bigtreetech/Tango-3D-Printer-Motherboard/Motherboard Picture/Motherboard.jpg

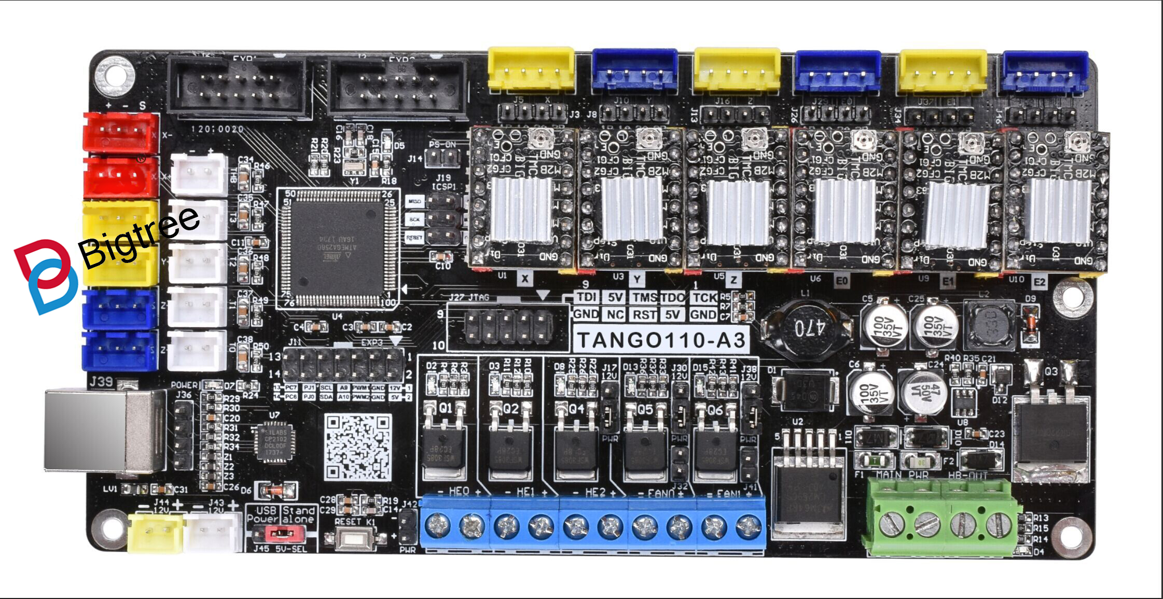
Motherboard Picture/Motherboard.jpg
