bigtreetech/Tango-3D-Printer-Motherboard/README.md

# Tango
An Open Source ATMEGA2560 based 3D printer controller board.
