bigtreetech/Tango-3D-Printer-Motherboard/PCB Diagram/Tango V1.0top.pdf

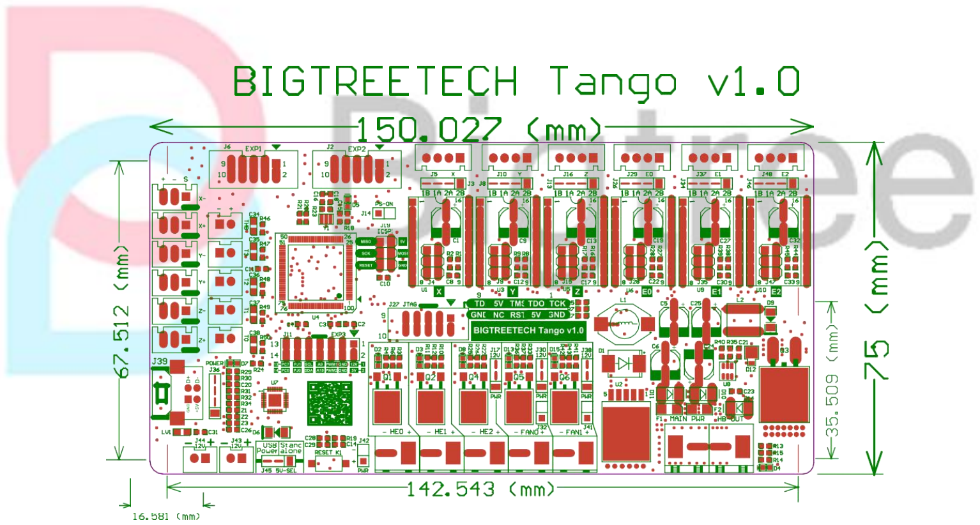
[picture p2: figure]
