bigtreetech/Tango-3D-Printer-Motherboard/Schematic/Tango V1.0.jpg

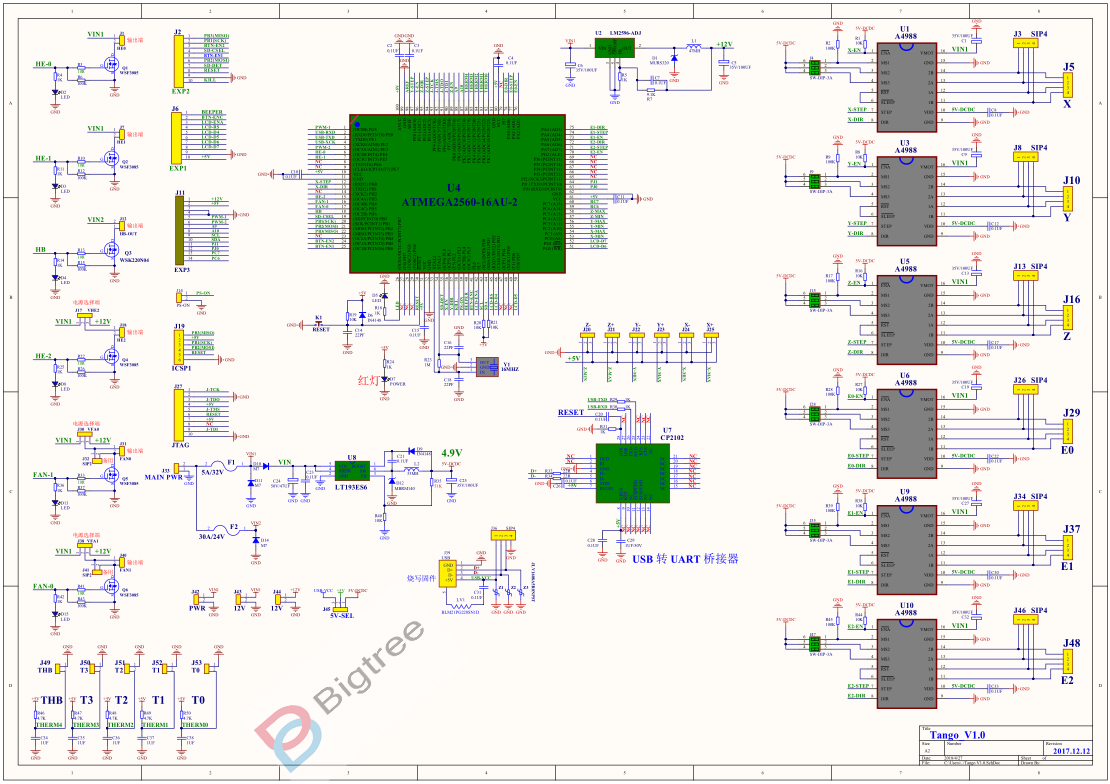
Schematic/Tango V1.0.jpg
