bigtreetech/Tango-3D-Printer-Motherboard/PCB Diagram/Tango V1bot.pdf

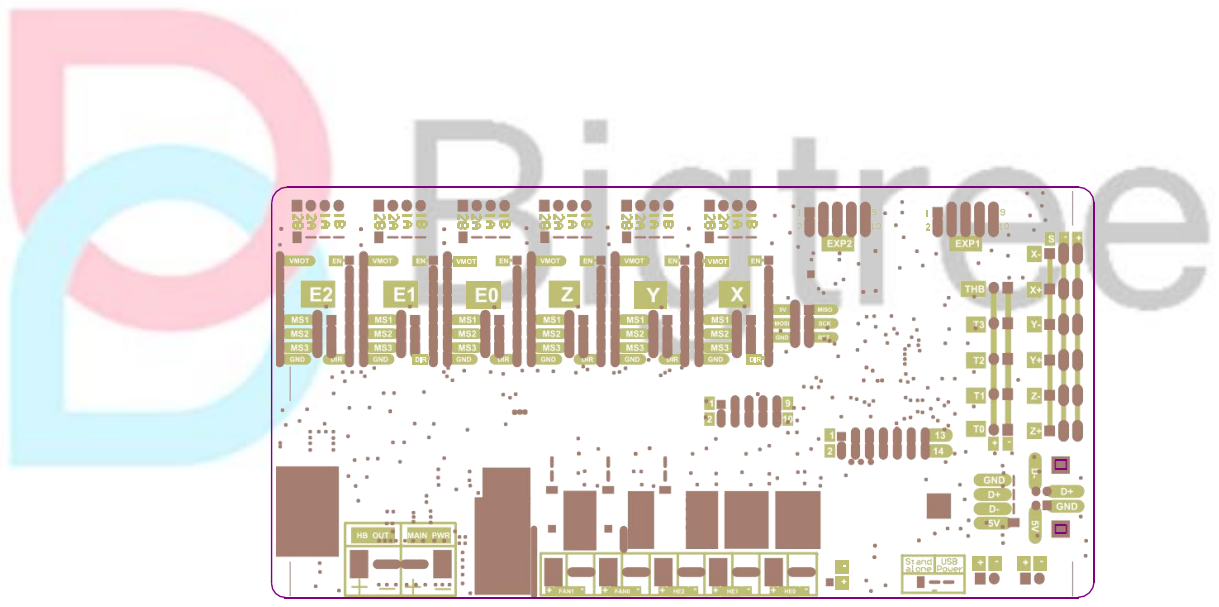
[picture p4: page 1]
