bigtreetech/Tango-3D-Printer-Motherboard/(list of files, drawings)

Other design files:
Schematic/Tango V1.0.SchDoc
