bigtreetech/Tango-3D-Printer-Motherboard/(threads)

Thread 3 (2019-02-09):

MARLIN ISSUES

ryanhmonument, 2019-02-09:
all three marlin tango revisions seem to be the same 1.1.8 and seem to be setup for a delta.. i'm fairly new to marlin, and i am trying to get my new board running on a cartesian, and currently i am getting an error as follows "homing_feedrate_xy was not declared in this scope" i have tried with my limited knowledge with no luck, if someone has the tango rumba up and running on a regular cartesian printer, i would love a copy and i cn just tweek my bed size, thermistors, probe, and leveling, lcd, and i should be able to upload and run, i have sucessfully got marlin uploaded to the board, however it's not a running setup, it says "printer killed, pleasse reset" after the marlin splash screen, i used my marlin setup that was running on my anet , nd just changed mother board to rumba. i am thankfull for any advice, or someone to share a running config..

jimhiggs, 2019-02-14:
I downloaded the stock Marlin 1.1.9 firmware and started from there. You are welcome to try my conf file.
Mine is a modified cubex wth E3d hotends, no hotbed  heater, raising bed Z azis and all endstops set for top, left, rear as 0,0,0 and I then use gcode to center 0,0,0  at center of bed.

/**
   Marlin 3D Printer Firmware
   Copyright (C) 2016 MarlinFirmware [https://github.com/MarlinFirmware/Marlin]

   Based on Sprinter and grbl.
   Copyright (C) 2011 Camiel Gubbels / Erik van der Zalm

   This program is free software: you can redistribute it and/or modify
   it under the terms of the GNU General Public License as published by
   the Free Software Foundation, either version 3 of the License, or
   (at your option) any later version.

   This program is distributed in the hope that it will be useful,
   but WITHOUT ANY WARRANTY; without even the implied warranty of
   MERCHANTABILITY or FITNESS FOR A PARTICULAR PURPOSE.  See the
   GNU General Public License for more details.

   You should have received a copy of the GNU General Public License
   along with this program.  If not, see <http://www.gnu.org/licenses/>.

*/

/**
   Configuration.h

   Basic settings such as:

   - Type of electronics
   - Type of temperature sensor
   - Printer geometry
   - Endstop configuration
   - LCD controller
   - Extra features

   Advanced settings can be found in Configuration_adv.h

*/
#ifndef CONFIGURATION_H
#define CONFIGURATION_H
#define CONFIGURATION_H_VERSION 010109

//===========================================================================
//============================= Getting Started =============================
//===========================================================================

/**
   Here are some standard links for getting your machine calibrated:

   http://reprap.org/wiki/Calibration
   http://youtu.be/wAL9d7FgInk
   http://calculator.josefprusa.cz
   http://reprap.org/wiki/Triffid_Hunter%27s_Calibration_Guide
   http://www.thingiverse.com/thing:5573
   https://sites.google.com/site/repraplogphase/calibration-of-your-reprap
   http://www.thingiverse.com/thing:298812
*/

//===========================================================================
//============================= DELTA Printer ===============================
//===========================================================================
// For a Delta printer start with one of the configuration files in the
// example_configurations/delta directory and customize for your machine.
//

//===========================================================================
//============================= SCARA Printer ===============================
//===========================================================================
// For a SCARA printer start with the configuration files in
// example_configurations/SCARA and customize for your machine.
//

// @section info

// User-specified version info of this build to display in [Pronterface, etc] terminal window during
// startup. Implementation of an idea by Prof Braino to inform user that any changes made to this
// build by the user have been successfully uploaded into firmware.
#define STRING_CONFIG_H_AUTHOR "Me" // Who made the changes.
//#define SHOW_BOOTSCREEN
//#define STRING_SPLASH_LINE1 SHORT_BUILD_VERSION // will be shown during bootup in line 1
//#define STRING_SPLASH_LINE2 WEBSITE_URL         // will be shown during bootup in line 2

/**
 * *** VENDORS PLEASE READ ***
 *
 * Marlin allows you to add a custom boot image for Graphical LCDs.
 * With this option Marlin will first show your custom screen followed
 * by the standard Marlin logo with version number and web URL.
 *
 * We encourage you to take advantage of this new feature and we also
 * respectfully request that you retain the unmodified Marlin boot screen.
 */

// Enable to show the bitmap in Marlin/_Bootscreen.h on startup.
//#define SHOW_CUSTOM_BOOTSCREEN

// Enable to show the bitmap in Marlin/_Statusscreen.h on the status screen.
//#define CUSTOM_STATUS_SCREEN_IMAGE

// @section machine

/**
 * Select the serial port on the board to use for communication with the host.
 * This allows the connection of wireless adapters (for instance) to non-default port pins.
 * Serial port 0 is always used by the Arduino bootloader regardless of this setting.
 *
 * :[0, 1, 2, 3, 4, 5, 6, 7]
*/
#define SERIAL_PORT 0

/**
   This setting determines the communication speed of the printer.

   250000 works in most cases, but you might try a lower speed if
   you commonly experience drop-outs during host printing.
   You may try up to 1000000 to speed up SD file transfer.

   :[2400, 9600, 19200, 38400, 57600, 115200, 250000, 500000, 1000000]
*/
#define BAUDRATE 115200

// Enable the Bluetooth serial interface on AT90USB devices
//#define BLUETOOTH

// The following define selects which electronics board you have.
// Please choose the name from boards.h that matches your setup
#ifndef MOTHERBOARD
#define MOTHERBOARD BOARD_RUMBA
#endif

// Optional custom name for your RepStrap or other custom machine
// Displayed in the LCD "Ready" message
#define CUSTOM_MACHINE_NAME "Reprap Cubex"

// Define this to set a unique identifier for this printer, (Used by some programs to differentiate between machines)
// You can use an online service to generate a random UUID. (eg http://www.uuidgenerator.net/version4)
//#define MACHINE_UUID "00000000-0000-0000-0000-000000000000"

// @section extruder

// This defines the number of extruders
// :[1, 2, 3, 4, 5]
#define EXTRUDERS 1

// Generally expected filament diameter (1.75, 2.85, 3.0, ...). Used for Volumetric, Filament Width Sensor, etc.
#define DEFAULT_NOMINAL_FILAMENT_DIA 1.75

// For Cyclops or any "multi-extruder" that shares a single nozzle.
//#define SINGLENOZZLE

/**
   Průša MK2 Single Nozzle Multi-Material Multiplexer, and variants.

   This device allows one stepper driver on a control board to drive
   two to eight stepper motors, one at a time, in a manner suitable
   for extruders.

   This option only allows the multiplexer to switch on tool-change.
   Additional options to configure custom E moves are pending.
*/
//#define MK2_MULTIPLEXER
#if ENABLED(MK2_MULTIPLEXER)
// Override the default DIO selector pins here, if needed.
// Some pins files may provide defaults for these pins.
//#define E_MUX0_PIN 40  // Always Required
//#define E_MUX1_PIN 42  // Needed for 3 to 8 steppers
//#define E_MUX2_PIN 44  // Needed for 5 to 8 steppers
#endif

// A dual extruder that uses a single stepper motor
//#define SWITCHING_EXTRUDER
#if ENABLED(SWITCHING_EXTRUDER)
#define SWITCHING_EXTRUDER_SERVO_NR 0
#define SWITCHING_EXTRUDER_SERVO_ANGLES { 0, 90 } // Angles for E0, E1[, E2, E3]
#if EXTRUDERS > 3
#define SWITCHING_EXTRUDER_E23_SERVO_NR 1
#endif
#endif

// A dual-nozzle that uses a servomotor to raise/lower one of the nozzles
//#define SWITCHING_NOZZLE
#if ENABLED(SWITCHING_NOZZLE)
#define SWITCHING_NOZZLE_SERVO_NR 0
#define SWITCHING_NOZZLE_SERVO_ANGLES { 0, 90 }   // Angles for E0, E1
//#define HOTEND_OFFSET_Z { 0.0, 0.0 }
#endif

/**
   Two separate X-carriages with extruders that connect to a moving part
   via a magnetic docking mechanism. Requires SOL1_PIN and SOL2_PIN.
*/
//#define PARKING_EXTRUDER
#if ENABLED(PARKING_EXTRUDER)
#define PARKING_EXTRUDER_SOLENOIDS_INVERT           // If enabled, the solenoid is NOT magnetized with applied voltage
#define PARKING_EXTRUDER_SOLENOIDS_PINS_ACTIVE LOW  // LOW or HIGH pin signal energizes the coil
#define PARKING_EXTRUDER_SOLENOIDS_DELAY 250        // Delay (ms) for magnetic field. No delay if 0 or not defined.
#define PARKING_EXTRUDER_PARKING_X { -78, 184 }     // X positions for parking the extruders
#define PARKING_EXTRUDER_GRAB_DISTANCE 1            // mm to move beyond the parking point to grab the extruder
#define PARKING_EXTRUDER_SECURITY_RAISE 5           // Z-raise before parking
#define HOTEND_OFFSET_Z { 0.0, 1.3 }                // Z-offsets of the two hotends. The first must be 0.
#endif

/**
 * "Mixing Extruder"
 *   - Adds G-codes M163 and M164 to set and "commit" the current mix factors.
 *   - Extends the stepping routines to move multiple steppers in proportion to the mix.
 *   - Optional support for Repetier Firmware's 'M164 S<index>' supporting virtual tools.
 *   - This implementation supports up to two mixing extruders.
 *   - Enable DIRECT_MIXING_IN_G1 for M165 and mixing in G1 (from Pia Taubert's reference implementation).
 */
//#define MIXING_EXTRUDER
#if ENABLED(MIXING_EXTRUDER)
#define MIXING_STEPPERS 2        // Number of steppers in your mixing extruder
#define MIXING_VIRTUAL_TOOLS 16  // Use the Virtual Tool method with M163 and M164
//#define DIRECT_MIXING_IN_G1    // Allow ABCDHI mix factors in G1 movement commands
#endif

// Offset of the extruders (uncomment if using more than one and relying on firmware to position when changing).
// The offset has to be X=0, Y=0 for the extruder 0 hotend (default extruder).
// For the other hotends it is their distance from the extruder 0 hotend.
//#define HOTEND_OFFSET_X {0.0, 20.00} // (in mm) for each extruder, offset of the hotend on the X axis
//#define HOTEND_OFFSET_Y {0.0, 5.00}  // (in mm) for each extruder, offset of the hotend on the Y axis

// @section machine

/**
 * Select your power supply here. Use 0 if you haven't connected the PS_ON_PIN
 *
 * 0 = No Power Switch
 * 1 = ATX
 * 2 = X-Box 360 203Watts (the blue wire connected to PS_ON and the red wire to VCC)
 *
 * :{ 0:'No power switch', 1:'ATX', 2:'X-Box 360' }
 */
#define POWER_SUPPLY 0

#if POWER_SUPPLY > 0
// Enable this option to leave the PSU off at startup.
// Power to steppers and heaters will need to be turned on with M80.
//#define PS_DEFAULT_OFF

 //#define AUTO_POWER_CONTROL        // Enable automatic control of the PS_ON pin
  #if ENABLED(AUTO_POWER_CONTROL)
    #define AUTO_POWER_FANS           // Turn on PSU if fans need power
    #define AUTO_POWER_E_FANS
    #define AUTO_POWER_CONTROLLERFAN
    #define POWER_TIMEOUT 30
  #endif

#endif

// @section temperature

//===========================================================================
//============================= Thermal Settings ============================
//===========================================================================

/**
 * --NORMAL IS 4.7kohm PULLUP!-- 1kohm pullup can be used on hotend sensor, using correct resistor and table
 *
 * Temperature sensors available:
 *
 *    -4 : thermocouple with AD8495
 *    -3 : thermocouple with MAX31855 (only for sensor 0)
 *    -2 : thermocouple with MAX6675 (only for sensor 0)
 *    -1 : thermocouple with AD595
 *     0 : not used
 *     1 : 100k thermistor - best choice for EPCOS 100k (4.7k pullup)
 *     2 : 200k thermistor - ATC Semitec 204GT-2 (4.7k pullup)
 *     3 : Mendel-parts thermistor (4.7k pullup)
 *     4 : 10k thermistor !! do not use it for a hotend. It gives bad resolution at high temp. !!
 *     5 : 100K thermistor - ATC Semitec 104GT-2/104NT-4-R025H42G (Used in ParCan & J-Head) (4.7k pullup)
 *   501 : 100K Zonestar (Tronxy X3A) Thermistor
 *     6 : 100k EPCOS - Not as accurate as table 1 (created using a fluke thermocouple) (4.7k pullup)
 *     7 : 100k Honeywell thermistor 135-104LAG-J01 (4.7k pullup)
 *    71 : 100k Honeywell thermistor 135-104LAF-J01 (4.7k pullup)
 *     8 : 100k 0603 SMD Vishay NTCS0603E3104FXT (4.7k pullup)
 *     9 : 100k GE Sensing AL03006-58.2K-97-G1 (4.7k pullup)
 *    10 : 100k RS thermistor 198-961 (4.7k pullup)
 *    11 : 100k beta 3950 1% thermistor (4.7k pullup)
 *    12 : 100k 0603 SMD Vishay NTCS0603E3104FXT (4.7k pullup) (calibrated for Makibox hot bed)
 *    13 : 100k Hisens 3950  1% up to 300°C for hotend "Simple ONE " & "Hotend "All In ONE"
 *    15 : 100k thermistor calibration for JGAurora A5 hotend
 *    20 : the PT100 circuit found in the Ultimainboard V2.x
 *    60 : 100k Maker's Tool Works Kapton Bed Thermistor beta=3950
 *    66 : 4.7M High Temperature thermistor from Dyze Design
 *    70 : the 100K thermistor found in the bq Hephestos 2
 *    75 : 100k Generic Silicon Heat Pad with NTC 100K MGB18-104F39050L32 thermistor
 *
 *       1k ohm pullup tables - This is atypical, and requires changing out the 4.7k pullup for 1k.
 *                              (but gives greater accuracy and more stable PID)
 *    51 : 100k thermistor - EPCOS (1k pullup)
 *    52 : 200k thermistor - ATC Semitec 204GT-2 (1k pullup)
 *    55 : 100k thermistor - ATC Semitec 104GT-2 (Used in ParCan & J-Head) (1k pullup)
 *
 *  1047 : Pt1000 with 4k7 pullup
 *  1010 : Pt1000 with 1k pullup (non standard)
 *   147 : Pt100 with 4k7 pullup
 *   110 : Pt100 with 1k pullup (non standard)
 *
 *         Use these for Testing or Development purposes. NEVER for production machine.
 *   998 : Dummy Table that ALWAYS reads 25°C or the temperature defined below.
 *   999 : Dummy Table that ALWAYS reads 100°C or the temperature defined below.
 *
 * :{ '0': "Not used", '1':"100k / 4.7k - EPCOS", '2':"200k / 4.7k - ATC Semitec 204GT-2", '3':"Mendel-parts / 4.7k", '4':"10k !! do not use for a hotend. Bad resolution at high temp. !!", '5':"100K / 4.7k - ATC Semitec 104GT-2 (Used in ParCan & J-Head)", '501':"100K Zonestar (Tronxy X3A)", '6':"100k / 4.7k EPCOS - Not as accurate as Table 1", '7':"100k / 4.7k Honeywell 135-104LAG-J01", '8':"100k / 4.7k 0603 SMD Vishay NTCS0603E3104FXT", '9':"100k / 4.7k GE Sensing AL03006-58.2K-97-G1", '10':"100k / 4.7k RS 198-961", '11':"100k / 4.7k beta 3950 1%", '12':"100k / 4.7k 0603 SMD Vishay NTCS0603E3104FXT (calibrated for Makibox hot bed)", '13':"100k Hisens 3950  1% up to 300°C for hotend 'Simple ONE ' & hotend 'All In ONE'", '20':"PT100 (Ultimainboard V2.x)", '51':"100k / 1k - EPCOS", '52':"200k / 1k - ATC Semitec 204GT-2", '55':"100k / 1k - ATC Semitec 104GT-2 (Used in ParCan & J-Head)", '60':"100k Maker's Tool Works Kapton Bed Thermistor beta=3950", '66':"Dyze Design 4.7M High Temperature thermistor", '70':"the 100K thermistor found in the bq Hephestos 2", '71':"100k / 4.7k Honeywell 135-104LAF-J01", '147':"Pt100 / 4.7k", '1047':"Pt1000 / 4.7k", '110':"Pt100 / 1k (non-standard)", '1010':"Pt1000 / 1k (non standard)", '-4':"Thermocouple + AD8495", '-3':"Thermocouple + MAX31855 (only for sensor 0)", '-2':"Thermocouple + MAX6675 (only for sensor 0)", '-1':"Thermocouple + AD595",'998':"Dummy 1", '999':"Dummy 2" }
 */

#define TEMP_SENSOR_0 11
#if EXTRUDERS == 2
  #define TEMP_SENSOR_1 11
#endif
#define TEMP_SENSOR_2 0
#define TEMP_SENSOR_3 0
#define TEMP_SENSOR_4 0
#define TEMP_SENSOR_BED 0
#define TEMP_SENSOR_CHAMBER 0

// Dummy thermistor constant temperature readings, for use with 998 and 999
#define DUMMY_THERMISTOR_998_VALUE 25
#define DUMMY_THERMISTOR_999_VALUE 100

// Use temp sensor 1 as a redundant sensor with sensor 0. If the readings
// from the two sensors differ too much the print will be aborted.
//#define TEMP_SENSOR_1_AS_REDUNDANT
#define MAX_REDUNDANT_TEMP_SENSOR_DIFF 5

// Extruder temperature must be close to target for this long before M109 returns success
#define TEMP_RESIDENCY_TIME 10 // (seconds)
#define TEMP_HYSTERESIS 3       // (degC) range of +/- temperatures considered "close" to the target one
#define TEMP_WINDOW     1       // (degC) Window around target to start the residency timer x degC early.

// Bed temperature must be close to target for this long before M190 returns success
#define TEMP_BED_RESIDENCY_TIME 10   // (seconds)
#define TEMP_BED_HYSTERESIS 3       // (degC) range of +/- temperatures considered "close" to the target one
#define TEMP_BED_WINDOW     1       // (degC) Window around target to start the residency timer x degC early.

// The minimal temperature defines the temperature below which the heater will not be enabled It is used
// to check that the wiring to the thermistor is not broken.
// Otherwise this would lead to the heater being powered on all the time.
#define HEATER_0_MINTEMP 5
#define HEATER_1_MINTEMP 5
#define HEATER_2_MINTEMP 5
#define HEATER_3_MINTEMP 5
#define HEATER_4_MINTEMP 5
#define BED_MINTEMP 5

// When temperature exceeds max temp, your heater will be switched off.
// This feature exists to protect your hotend from overheating accidentally, but *NOT* from thermistor short/failure!
// You should use MINTEMP for thermistor short/failure protection.
#define HEATER_0_MAXTEMP 275
#define HEATER_1_MAXTEMP 275
#define HEATER_2_MAXTEMP 275
#define HEATER_3_MAXTEMP 275
#define HEATER_4_MAXTEMP 275
#define BED_MAXTEMP 150

//===========================================================================
//============================= PID Settings ================================
//===========================================================================
// PID Tuning Guide here: http://reprap.org/wiki/PID_Tuning

// Comment the following line to disable PID and enable bang-bang.
#define PIDTEMP
#define BANG_MAX 255     // Limits current to nozzle while in bang-bang mode; 255=full current
#define PID_MAX BANG_MAX // Limits current to nozzle while PID is active (see PID_FUNCTIONAL_RANGE below); 255=full current
#define PID_K1 0.95      // Smoothing factor within any PID loop
#if ENABLED(PIDTEMP)
#define PID_AUTOTUNE_MENU // Add PID Autotune to the LCD "Temperature" menu to run M303 and apply the result.
//#define PID_DEBUG // Sends debug data to the serial port.
//#define PID_OPENLOOP 1 // Puts PID in open loop. M104/M140 sets the output power from 0 to PID_MAX
//#define SLOW_PWM_HEATERS // PWM with very low frequency (roughly 0.125Hz=8s) and minimum state time of approximately 1s useful for heaters driven by a relay
//#define PID_PARAMS_PER_HOTEND // Uses separate PID parameters for each extruder (useful for mismatched extruders)
// Set/get with gcode: M301 E[extruder number, 0-2]
#define PID_FUNCTIONAL_RANGE 10 // If the temperature difference between the target temperature and the actual temperature
// is more than PID_FUNCTIONAL_RANGE then the PID will be shut off and the heater will be set to min/max.

// If you are using a pre-configured hotend then you can use one of the value sets by uncommenting it

// Ultimaker
//#define  DEFAULT_Kp 22.2
//#define  DEFAULT_Ki 1.08
//#define  DEFAULT_Kd 114

// MakerGear
//#define  DEFAULT_Kp 7.0
//#define  DEFAULT_Ki 0.1
//#define  DEFAULT_Kd 12

// Mendel Parts V9 on 12V
//#define  DEFAULT_Kp 63.0
//#define  DEFAULT_Ki 2.25
//#define  DEFAULT_Kd 440

//E3D with 30MM fan
#define  DEFAULT_Kp 24.77
#define  DEFAULT_Ki 1.84
#define  DEFAULT_Kd 83.61

#endif // PIDTEMP

//===========================================================================
//============================= PID > Bed Temperature Control ===============
//===========================================================================

/**
 * PID Bed Heating
 *
 * If this option is enabled set PID constants below.
 * If this option is disabled, bang-bang will be used and BED_LIMIT_SWITCHING will enable hysteresis.
 *
 * The PID frequency will be the same as the extruder PWM.
 * If PID_dT is the default, and correct for the hardware/configuration, that means 7.689Hz,
 * which is fine for driving a square wave into a resistive load and does not significantly
 * impact FET heating. This also works fine on a Fotek SSR-10DA Solid State Relay into a 250W
 * heater. If your configuration is significantly different than this and you don't understand
 * the issues involved, don't use bed PID until someone else verifies that your hardware works.
 */
//#define PIDTEMPBED

//#define BED_LIMIT_SWITCHING

/**
 * Max Bed Power
 * Applies to all forms of bed control (PID, bang-bang, and bang-bang with hysteresis).
 * When set to any value below 255, enables a form of PWM to the bed that acts like a divider
 * so don't use it unless you are OK with PWM on your bed. (See the comment on enabling PIDTEMPBED)
 */
#define MAX_BED_POWER 255 // limits duty cycle to bed; 255=full current

#if ENABLED(PIDTEMPBED)

//#define PID_BED_DEBUG // Sends debug data to the serial port.

//120V 250W silicone heater into 4mm borosilicate (MendelMax 1.5+)
//from FOPDT model - kp=.39 Tp=405 Tdead=66, Tc set to 79.2, aggressive factor of .15 (vs .1, 1, 10)
//#define  DEFAULT_bedKp 10.00
//#define  DEFAULT_bedKi .023
//#define  DEFAULT_bedKd 305.4

//120V 250W silicone heater into 4mm borosilicate (MendelMax 1.5+)
//from pidautotune
//#define  DEFAULT_bedKp 97.1
//#define  DEFAULT_bedKi 1.41
//#define  DEFAULT_bedKd 1675.16

//D-force
//#define  DEFAULT_bedKp 22.97
//#define  DEFAULT_bedKi 3.76
//#define  DEFAULT_bedKd 29.2

// FIND YOUR OWN: "M303 E-1 C8 S90" to run autotune on the bed at 90 degreesC for 8 cycles.
#endif // PIDTEMPBED

// @section extruder

/**
 * Prevent extrusion if the temperature is below EXTRUDE_MINTEMP.
 * Add M302 to set the minimum extrusion temperature and/or turn
 * cold extrusion prevention on and off.
 *
 * *** IT IS HIGHLY RECOMMENDED TO LEAVE THIS OPTION ENABLED! ***
 */
#define PREVENT_COLD_EXTRUSION
#define EXTRUDE_MINTEMP 170

/**
 * Prevent a single extrusion longer than EXTRUDE_MAXLENGTH.
 * Note: For Bowden Extruders make this large enough to allow load/unload.
 */
#define PREVENT_LENGTHY_EXTRUDE
#define EXTRUDE_MAXLENGTH 300

//===========================================================================
//======================== Thermal Runaway Protection =======================
//===========================================================================

/**
 * Thermal Protection provides additional protection to your printer from damage
 * and fire. Marlin always includes safe min and max temperature ranges which
 * protect against a broken or disconnected thermistor wire.
 *
 * The issue: If a thermistor falls out, it will report the much lower
 * temperature of the air in the room, and the the firmware will keep
 * the heater on.
 *
 * If you get "Thermal Runaway" or "Heating failed" errors the
 * details can be tuned in Configuration_adv.h
 */

#define THERMAL_PROTECTION_HOTENDS // Enable thermal protection for all extruders
// #define THERMAL_PROTECTION_BED     // Enable thermal protection for the heated bed

//===========================================================================
//============================= Mechanical Settings =========================
//===========================================================================

// @section machine

// Uncomment one of these options to enable CoreXY, CoreXZ, or CoreYZ kinematics
// either in the usual order or reversed
//#define COREXY
//#define COREXZ
//#define COREYZ
//#define COREYX
//#define COREZX
//#define COREZY

//===========================================================================
//============================== Endstop Settings ===========================
//===========================================================================

// @section homing

// Specify here all the endstop connectors that are connected to any endstop or probe.
// Almost all printers will be using one per axis. Probes will use one or more of the
// extra connectors. Leave undefined any used for non-endstop and non-probe purposes.
#define USE_XMIN_PLUG
#define USE_YMIN_PLUG
#define USE_ZMIN_PLUG
//#define USE_XMAX_PLUG
//#define USE_YMAX_PLUG
//#define USE_ZMAX_PLUG

// Enable pullup for all endstops to prevent a floating state
#define ENDSTOPPULLUPS
#if DISABLED(ENDSTOPPULLUPS)
// Disable ENDSTOPPULLUPS to set pullups individually
//#define ENDSTOPPULLUP_XMAX
//#define ENDSTOPPULLUP_YMAX
//#define ENDSTOPPULLUP_ZMAX
//#define ENDSTOPPULLUP_XMIN
//#define ENDSTOPPULLUP_YMIN
//#define ENDSTOPPULLUP_ZMIN
//#define ENDSTOPPULLUP_ZMIN_PROBE
#endif

// Mechanical endstop with COM to ground and NC to Signal uses "false" here (most common setup).
#define X_MIN_ENDSTOP_INVERTING true // set to true to invert the logic of the endstop.
#define Y_MIN_ENDSTOP_INVERTING true // set to true to invert the logic of the endstop.
#define Z_MIN_ENDSTOP_INVERTING true // set to true to invert the logic of the endstop.
#define X_MAX_ENDSTOP_INVERTING true // set to true to invert the logic of the endstop.
#define Y_MAX_ENDSTOP_INVERTING true // set to true to invert the logic of the endstop.
#define Z_MAX_ENDSTOP_INVERTING true // set to true to invert the logic of the endstop.
#define Z_MIN_PROBE_ENDSTOP_INVERTING true // set to true to invert the logic of the probe.

/**
 * Stepper Drivers
 *
 * These settings allow Marlin to tune stepper driver timing and enable advanced options for
 * stepper drivers that support them. You may also override timing options in Configuration_adv.h.
 *
 * A4988 is assumed for unspecified drivers.
 *
 * Options: A4988, DRV8825, LV8729, L6470, TB6560, TB6600, TMC2100,
 *          TMC2130, TMC2130_STANDALONE, TMC2208, TMC2208_STANDALONE,
 *          TMC26X,  TMC26X_STANDALONE,  TMC2660, TMC2660_STANDALONE,
 *          TMC5130, TMC5130_STANDALONE
 * :['A4988', 'DRV8825', 'LV8729', 'L6470', 'TB6560', 'TB6600', 'TMC2100', 'TMC2130', 'TMC2130_STANDALONE', 'TMC2208', 'TMC2208_STANDALONE', 'TMC26X', 'TMC26X_STANDALONE', 'TMC2660', 'TMC2660_STANDALONE', 'TMC5130', 'TMC5130_STANDALONE']
 */
#define X_DRIVER_TYPE  DRV8825
#define Y_DRIVER_TYPE  DRV8825
#define Z_DRIVER_TYPE  DRV8825
//#define X2_DRIVER_TYPE DRV8825
#define Y2_DRIVER_TYPE DRV8825
//#define Z2_DRIVER_TYPE DRV8825
#define E0_DRIVER_TYPE DRV8825
#define E1_DRIVER_TYPE DRV8825
//#define E2_DRIVER_TYPE DRV8825
//#define E3_DRIVER_TYPE DRV8825
//#define E4_DRIVER_TYPE DRV8825

// Enable this feature if all enabled endstop pins are interrupt-capable.
// This will remove the need to poll the interrupt pins, saving many CPU cycles.
//#define ENDSTOP_INTERRUPTS_FEATURE

/**
 * Endstop Noise Filter
 *
 * Enable this option if endstops falsely trigger due to noise.
 * NOTE: Enabling this feature means adds an error of +/-0.2mm, so homing
 * will end up at a slightly different position on each G28. This will also
 * reduce accuracy of some bed probes.
 * For mechanical switches, the better approach to reduce noise is to install
 * a 100 nanofarads ceramic capacitor in parallel with the switch, making it
 * essentially noise-proof without sacrificing accuracy.
 * This option also increases MCU load when endstops or the probe are enabled.
 * So this is not recommended. USE AT YOUR OWN RISK.
 * (This feature is not required for common micro-switches mounted on PCBs
 * based on the Makerbot design, since they already include the 100nF capacitor.)
 */
//#define ENDSTOP_NOISE_FILTER

//=============================================================================
//============================== Movement Settings ============================
//=============================================================================
// @section motion

/**
 * Default Settings
 *
 * These settings can be reset by M502
 *
 * Note that if EEPROM is enabled, saved values will override these.
 */

/**
 * With this option each E stepper can have its own factors for the
 * following movement settings. If fewer factors are given than the
 * total number of extruders, the last value applies to the rest.
 */
//#define DISTINCT_E_FACTORS

/**
 * Default Axis Steps Per Unit (steps/mm)
 * Override with M92
 *                                      X, Y, Z, E0 [, E1[, E2[, E3[, E4]]]]
 */
#define DEFAULT_AXIS_STEPS_PER_UNIT   {175.5,175.5,2143.4,165}
/**
 * Default Max Feed Rate (mm/s)
 * Override with M203
 *                                      X, Y, Z, E0 [, E1[, E2[, E3[, E4]]]]
 */
#define DEFAULT_MAX_FEEDRATE          { 300, 300, 5, 25 }

/**
 * Default Max Acceleration (change/s) change = mm/s
 * (Maximum start speed for accelerated moves)
 * Override with M201
 *                                      X, Y, Z, E0 [, E1[, E2[, E3[, E4]]]]
 */
#define DEFAULT_MAX_ACCELERATION      { 400, 400, 100, 500 }

/**
 * Default Acceleration (change/s) change = mm/s
 * Override with M204
 *
 *   M204 P    Acceleration
 *   M204 R    Retract Acceleration
 *   M204 T    Travel Acceleration
 */
#define DEFAULT_ACCELERATION          400    // X, Y, Z and E acceleration for printing moves
#define DEFAULT_RETRACT_ACCELERATION  500    // E acceleration for retracts
#define DEFAULT_TRAVEL_ACCELERATION   400    // X, Y, Z acceleration for travel (non printing) moves

/**
 * Default Jerk (mm/s)
 * Override with M205 X Y Z E
 *
 * "Jerk" specifies the minimum speed change that requires acceleration.
 * When changing speed and direction, if the difference is less
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

Thread 4 (2019-02-25):

Can't get it to work on Anet A8

Pan369, 2019-02-25:
Hi there! I am having a hard time connecting the Tango v1 board to my Anet A8 with BLTouch sensor and Anet 12864 Full Graphics LCD. Apparently the connections EXP1 & EXP2 don't match the ones on the LCD. I have smoked the first board I bought trying out the different procedures on youtube so I bought a second one, hastily.  Also, I thought it wouldn't be so difficult to add an SD card reader but I can't find any instructions on how to. I would really appreciate some help. Thank you in advance!

Dloranger, 2019-02-26:
if you find the info on the bltouch pinout please let me know, I have the tango on my Anet A8 (heavily modified for tri-color), but I have the discount full graphic LCD from a ramps kit and it is working fine, have almost everything ready except the touch probe as I can't find a pinout diagram for the touch

Dloranger, 2019-02-28:
I figured out the BL touch and have my setup about 99% working including the 3dtouch.  only thing I am currently fighting with is extruder 1 doesn't work, it drives extruder 0, (i am upgrading to a diamond hot end).  If you run a single extruder you should be fine, just change the number of extruders back to zero.

[marlin-1_1_9.zip](https://github.com/bigtreetech/Tango-3D-Printer-Motherboard/files/2915851/marlin-1_1_9.zip).

I have the bltouch configured this way, using the input for ZMAX as the input from the touch probe.  this is set in the pin_ramps.h file (look for servo0) you will see the setting is 32, where the default is 5 in the zip above.  note that you will need to adjust the position of your probe in the configuration file based on your setup, but everything else should be right for the A8

https://www.antclabs.com/wiring2

Once I get everything working I will do a proper drawing of the connections for the touch and etc.

Hope this helps you get going

PP369, 2019-03-08:
Thanks Dloranger! I am trying it out now, I'll let ya all know how I go.

PP369, 2019-03-08:
B.t.w. I gave up trying with the Anet 12864 Full Graphics LCD and got myself a Reprap Discount Full Graphics LCD which works fine on the Tango board but not with the Ramps & Arduino it came with D:

wolfiejp, 2019-05-23:
HEY ALL.  how did you get on with this,  did anyone mange to get the bltouch working with this mobo?  like most of you i have the anet a8 but wanted more,   hitting a brick wall with this board as there does not seem to be much supporting docs with it,  if anyone can shed light on this i'll be greatfull

thanks

Aurawin, 2019-05-23:
The Tango v1 works great here.  Exp1 and 2 are not for servo pins. They are exclusively for display and sd card readers.

The gnd, 5v, servo pins are located on additional header. I think they are 1,3,5.  On the odd bank of pins.  I can get a pic. But the board is labeled.

wolfiejp, 2019-05-23:
I'm getting there. all powered up for the first time tonight. got the motors to move lol all good so far,   will try to attach a Bl-touch tomorrow,

its a shame the board isnt documented well as it does seem to be the bees knees. but time will tell.

Dloranger, 2019-05-24:
I have the board working fully with bltouch and running a diamond tri-color
hot end, works great other than nozzle drool on the hot-end, but thats not
the boards fault.  it will work I assure you

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

--
Daniel Loranger

wolfiejp, 2019-05-24:
hey thanks for the replies.   im starting to wonder if my board is defective,  i send code to move X axis and Y moves,  i send code to move Y and Z will move,  i send code to move Z and X+Y+E1 move.

Other times i send code to say move Y 130 mm  and it will move a little and then another random axis will move a little as well.

I was hoping to be set  up and printing by now but  i might have to give this up as a bad joke.

has any one had issues like this?

Aurawin, 2019-05-24:
Those are strange symptoms.  what are your stepper drivers?
what are the jumpers for the stepper drivers set to? how did you calibrate the steps per millimeter? are you using micro steps?

wolfiejp, 2019-05-24:
The drivers are A4988's    no jumpers      and that's as far as ive got,  no calibrations as of yet,  i was just checking if the motors worked,

Aurawin, 2019-05-24:
The next thing would be to verify the wire order for your steppers.  then I would verify firmware settings for the proper drivers for each axis. this tango board is very forgiving. I'm pretty sure it's going to be an issue you can fix

wolfiejp, 2019-05-24:
I'll  have to google how to check the order for the motors, what i did was a straight swap with the motors from my A8,

I think i have the firmware all set up correct, i'll have another look in the morning as ive been working on this all day and i admit defeat for today at least.

Thank you for your comments today,

Has anyone got a firmware set up so i can have a look just to double check i have mine correct,

Have a good weekend

Dloranger, 2019-05-25:
I would say for the x driving y, and y driving Z, you likely just have the wires on the wrong stepper driver connector, that should be an easy fix.  For the Z driving 3 motors, that is really strange and I can't reconcile that.

You do need the jumpers under the drivers to be closed, that really messed with me until I figured that out.  I think you need all of them for it to work properly, my motors just buzzed and chattered until I did those jumpers.  From there is was a lot smoother sailing.  I don't think there is any reason to change the wiring unless did some weird twisting around and randomly shoved the wires into the sockets.

Here is my last edit to the marlin (entire folder) as I had to hack one of the pins for the touch as well, which I assume you also will want.  Think its setup for z max on the touch gpio.  I would send you pictures of everything, but its all in a cabinet and not accessible at all.

[marlin_1_1_9.zip](https://github.com/bigtreetech/Tango-3D-Printer-Motherboard/files/3219121/marlin_1_1_9.zip)

wolfiejp, 2019-05-25:
Thanks Dloranger for your input. I know the motors are in the correct ports as ive pulled all my motors out and no commands correspond to the correct axis,  Its most strange some times a Gcode command to move Axis Y will move Y but a minute or two later i can send the same Gcode and it will move Y + Z  Or Y + X.

I didn't have a Clue that i had to do anything with the jumpers, i'll try as you have suggested and hope it corrects it,

Once ive had a coffee or three i'll double check the wiring for the motors,

Thank you for sending me your marlin config It should be easy enough for me to spot if its a config error on my end or if its something else.

I have another Tango board arriving today as i have a feeling it could be the board that at fault.

Fingers crossed i get it all sorted and printing soon if not i think im going to have to look for another board with support for more then one Extruder

Thanks again

#

Aurawin, 2019-05-25:
Just a note. Closing All 3 rows means u are micro stepping at 1/32.  so your firmware and feedrate need to be adjusted

Aurawin, 2019-05-25:
Also, when I said to check the wires for each stepper I meant to verify AaBb wires correspond to the driver output. you may need to adjust wires at the molex. I did. under the board gives you labels to check.  you also need your wire diagram for the steppers.  assuming motors are all the same you can examine one.

wolfiejp, 2019-05-25:
Thanks Aurawin,  Looks like i have a busy day ahead of me,   Fingers crossed

wolfiejp, 2019-05-25:
Ok not a bad day, got the board wired up powered up and the correct motors now move when they should " perhaps i had a bad board but the new one no problems with that bit"

Few problems still remain tho, Did anyone have any issues with there End stops,   i have tried two different once today the bog standard ones that came with my A8 and also some Makerbot v3's i have. Neither seem to trigger a EndStop Event.    No doubt im missing something in the firmware so any hints would be great.

Got to work out the way to use Dual Z Axis,  ive read you can use one of the extruder ports for the Z-b Axis,  as i do not feel comfortable duelling them from the one Z Axis port, "

The Bl touch Well im going to have to come back to that one. Lack of information found on the internet and i dont wish to make things worse so it can wait.

Have a good weekend all and thanks for getting me this far ;-)  Hope to be off printing soon ;-)

ttfn

Aurawin, 2019-05-26:
Endstops are either NO or NC.  Ideally you want normally closed.  If the switch fails the board will detect a constant problem.

So first I would set my limit switches to NC.  If you don't know just use a DMM swapping pins if needed.

Then you want to match up the endstops in the configuration.h

Dloranger, 2019-05-26:
I ganged my Z as I had to build new crimp blocks anyways so I can;t help
with that part.

as for the end stops, 2 things to check

1)  are you using the correct ones? for the A8 it only has mins, so you
have to disable the max option, note if you are using my code base, the
zmin is done with the bl touch not the original a8 stop

2) you may need to invert the logic if the motors will only travel in one
direction.  This took a while to figure out as well as the code allows you
to go away from the stop forever, but never towards is the logic is
inverted.

Good Luck

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

--
Daniel Loranger

Aurawin, 2019-05-26:
Configuration.h values:

#define MOTHERBOARD BOARD_RUMBA
#define X_DRIVER_TYPE (YOUR STEPPER DRIVER HERE)
#define REVERSE_MENU_DIRECTION
#define DISPLAY_CHARSET_HD44780 WESTERN
#define LCD_LANGUAGE en

#define X_MIN_ENDSTOP_INVERTING false // set to true to invert the logic of the endstop.
#define Y_MIN_ENDSTOP_INVERTING false // set to true to invert the logic of the endstop.
#define Z_MIN_ENDSTOP_INVERTING false // set to true to invert the logic of the endstop.
#define X_MAX_ENDSTOP_INVERTING false // set to true to invert the logic of the endstop.
#define Y_MAX_ENDSTOP_INVERTING false // set to true to invert the logic of the endstop.
#define Z_MAX_ENDSTOP_INVERTING false // set to true to invert the logic of the endstop.
#define Z_MIN_PROBE_ENDSTOP_INVERTING false // set to true to invert the logic of the probe.

#define SOFT_ENDSTOPS_MENU_ITEM
#define AUTO_BED_LEVELING_UBL
#define RESTORE_LEVELING_AFTER_G28
#define MULTIPLE_PROBING 2
#define ENDSTOPPULLUPS
#define BLTOUCH
#if ENABLED(BLTOUCH)
  #define BLTOUCH_DELAY 200   // (ms) Enable and increase if needed

  /**
   * BLTouch V3.0 and newer smart series
   * For genuine BLTouch 3.0 sensors. Clones may be confused by 3.0 command angles. YMMV.
   * If the pin trigger is not detected, first try swapping the black and white wires then toggle this.
   */
  #define BLTOUCH_V3
  #if ENABLED(BLTOUCH_V3)
    #define BLTOUCH_FORCE_5V_MODE
    //#define BLTOUCH_FORCE_OPEN_DRAIN_MODE
  #endif
#endif

Configuration_adv.h

#define EXTRA_FAN_SPEED
#define Z_STEPPER_ALIGN_ITERATIONS
#define Z_STEPPER_AUTO_ALIGN
  #define Z_STEPPER_ALIGN_X { 25, 248 }
  #define Z_STEPPER_ALIGN_Y { 150, 150 }

#define Z_DUAL_STEPPER_DRIVERS
#define Z_STEPPER_AUTO_ALIGN
#define MICROSTEP32 HIGH,HIGH,HIGH
#define MICROSTEP_MODES { 32, 32, 32, 32, 32 } // [1,2,4,8,16]

#define E0_AUTO_FAN_PIN 8 // note that if you swap out the fan0 - fan1 on the board you don't need this but if fan0 is the extruder fan I needed this option to remap the outputs labeled on the board.

#define EXTRUDER_AUTO_FAN_TEMPERATURE 120 // sets fan on when the extruder reaches this temp
#define PINS_DEBUGGING

Aurawin, 2019-05-26:
If any of your steppers move in reverse look for any of these items and swap your values needed

#define INVERT_X_DIR TRUE/FALSE
#define INVERT_Y_DIR TRUE/FALSE
#define INVERT_Z_DIR TRUE/FALSE
#define INVERT_E0_DIR TRUE/FALSE

wolfiejp, 2019-05-26:
Thanks all for your input,  all seems to be working now apart from the BLTouch..

Fingers crossed i should be printing soon,

Dloranger, 2019-08-21:
Is this topic still open, not an admin by any means, just thinking it is best to close it when resolved. Keeps it cleaner if anyone else comes looking for help.

Thread 5 (2019-02-26):

How to connect BL touch?

Dloranger, 2019-02-26:
I cant find any information on adding a BL touch style probe.  Where to connect the pins?

wolfiejp, 2019-05-26:
did you find a solution to this ?

Dloranger, 2019-05-26:
Yes, I have it all working on my printer.

 you have to use one of the servo motor pins and one of the end stops connectors for power and the gpio pin.  I never found any documentation so I had to hack my way into it.  I think I commented the pins.h file I sent you in the other bug with the change to the pins behavior.  Power and ground should be simple to figure out for what is convenient.  I would have to tear open my setup to figure out the servo stuff as I just dont remember what I did there.

I know I followed one of the ant-labs wiring guides to figure it out alongside the schematics.

If I have time I will try to get a pinout for you, but its unlikely in the next week as I am very busy trying to get ready for a regional convention next week.  poke me again if you dont hear from me after that

wolfiejp, 2019-05-26:
Ok buddy no worries, i'll keep plugging away at it  but like you ive found very little info out there to help, im not as eager to go poking around with out instruction as i really haven't got a clue what im doing tbh,

Not done to bad tho as its only the BLT ive not set up yet,

i'll give you a shout next weekend if im still stuck

have fun at your convention

all the best

Dloranger, 2019-05-27:
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

Best I can do, hopefully you can get it figured out from this.

wolfiejp, 2019-05-27:
Thanks.   tbh im not sure which cables what in that pic lol

Dloranger, 2019-05-27:
From the power led, first left (2 white wires) is the temp probe.

Below that is a yellow 3 terminal block, this is the 3 wire cable from the
touch probe.

The next left 3 terminal block is the 2 wire cable. The bottom pin is
unused on this one.

I will try to get a propper drawing done with the pins more closely labeled
on a diagram

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

wolfiejp, 2019-07-13:
ok i admit defeat, any chance of that drawing?

Cheers

Dloranger, 2019-08-21:
I haven't heard anything on this bug report for 3 months so I am closing it with the solution given, feel free to comment with actual signal names on a drawing if you are so inclined or need further help

Closed 2019-08-21.

Thread 6 (2019-04-02):

Help with the stepper pins for TMC2130 v1.1 in Marlin config

Pan369, 2019-04-02:

Pan369, 2019-04-02:
According to this schematic, I connect the SDI to MOSI > pin 21, SCK to SCK > pin20, SDO to MISO >pin 22 and the CS pins for X,Y,Z, and E0 to EXP3 pins 59,63,45 and 60 as in this setup:
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
What am I doing wrong?

[Tango.V1.schema.pdf](https://github.com/bigtreetech/Tango-3D-Printer-Motherboard/files/3036207/Tango.V1.schema.pdf)

k2ironman, 2021-07-06:
Having the same issue with TMC5160 v1.2
On serial I receive "Testing X connection... Error: All LOW"

Thread 7 (2019-05-08):

Upgrade to 1.1.9

lacchinig, 2019-05-08:
I'm trying to update the firmware to release 1.1.9
The mainly problem is the LCD reprap smart controller 128x64 which become unstable, and the screen will be corrupted with buzzer every switched on.
Which is the problem?
Thks in advance

Thread 8 (2019-09-21):

Issues Compiling for Marlin1.1.8

madredss, 2019-09-21:
Ive gone through customizing what I need, but when I try to verify the file I get "Error compiling for Arduino/Genuino or Mega2560".  Any ideas?

Ernst-Edel, 2019-11-24:
Did you change the board name?

Thread 9 (2019-10-14):

Connexion issues

rdGasquet, 2019-10-14:
Hello,

My computer (under windows 10) didn't recognize the Tango V1.0 when i connect it via usb. In the device manager it tells "unkown usb device (device descriptor request failed)". I didn't find any specific drivers to install in this github or in the documentation.
Thx in advance for your answer and help.

wolfiejp, 2019-10-14:
Wow how strange, mine did this yesterday as I was attempting re-uploading Marlin,  Not found out whats happened yet, will let you know if I find out whats happened

rdGasquet, 2019-10-14:
i run the 18362.418 windows 10 version.
Actually i have 2 tango board, one already burn from BIGTREETECH but still detected by my computer but with the previous message. The other one is from BIQU and brand new. But this second one isn't detected at all by my computer.
In both case, the USB to UART chip is a SCILAB CP2102 DCL00X and i download and install the last corresponding drivers here
https://www.silabs.com/products/development-tools/software/usb-to-uart-bridge-vcp-drivers

Tell me when you have some news!

Aurawin, 2019-10-15:
Google CP210xVCPInstaller_x64 for the 64bit version.  Try that.  Mine works fine.

wolfiejp, 2019-10-15:
Thanks will give that a go later on today

rdGasquet, 2019-10-15:
I've already install it (i can see the driver program in control panel > program)
But when i connect the board to my computer nothing happened. In the device manager i've nothing with yellow label, or unknown device, or in the port COM list.

I've connected only one bridge on the board (to put the usb power ) and nothing else connected. Do i have to bridge something else ? or connect the board with the main power ?

(And it's not about my computer because i tried on an other one).

Thread 10 (2019-11-25):

Hotend Fan connection

jgwinner, 2019-11-25:
Hi

Great board, I'm having fun with it.

I can't see where to connect the Hotend heatsink fan. NOT the part cooling fan, that's the PWM outputs. As near as I can tell it's not a PWM fan, just an on/off fan, but I don't really want to just repurpose the PWM fans or I'll run out of pins.

So, where should the heatsink cooling fan be connected to?

        == John ==

jgwinner, 2019-11-27:
Anyone?

Aurawin, 2019-11-27:
Hot-end heat sync is PWM FAN0.  That is what we all use for Marlin.  Most set fan to 100% but still marlin turns fan on at setpoint.  What you propose is keeping the fan on at boot.  You can do that by selecting one of the 2 12V two pin headers.  On the corner.  One white.  One yellow.  Either will power your fan.

You can borrow a connector from some other 2pin fan and solder.  You will have a printer that has it's heatsink fan running all the time.  This will delay preheats.

jgwinner, 2019-11-28:
Thanks!

I don't want the fan on all the time, I just want to know where to connect it, but I don't think the Heatsink fan needs PWM, just a controllable on/off.

Using Fan0 confuses me if I have more than 1 extruder.Do you put all part cooling fans on Fan1 and all heatsink fans on Fan0?

To be clear, if I used all 3 extruders, I'd need 6 fans, and we're out of PWM outputs. 3 heatsinks, and 3 part cooling fans, in addition to the 3 extruder heaters.

One way or another, we need 9 PWM outputs for a full 3 extruder setup. I actually usually print PETG in which case I rarely use a part cooling fan, but as you mention, if the heatsink fan is always on, it would delay preheats, and I do occasionally print PetG so I need a cooling fan.

First Alternative:

If I only have 2 extruders, I could use Extruder 0 and 1 for the heaters, Extruder 2 for part cooling fan 0, Fan0 for part cooling fan 1, and Fan 1 for both heatsink fans. I'd have to check Marlin to see how to do that, I'd be worried that if I had only one extruder running it might turn on the heatsink fan for extruder 1, then turn the same pin off for extruder 1.

Second alternative: Put ALL cooing fans on Fan 0, and ALL Heatsink fans on Fan 1. Disadvantage; no multi-material.

Third Alternative: Run J11 pins 5 and 6 to an external MOSFET(s) for Extruder 0 and 1, and use the onboard MOSFET pins for most of the fans. Rearrange Marlin of course. Can I use J11 pins 5 and 6? The PCB diagram doesn't show them connected to anything else.

Thoughts?

jgwinner, 2019-12-07:
I'm not seeing any docs on what pin assignments should be for these. I opened the PCB with Altium, and the pins on the chip seem to be pretty different than what I expected - for example, Y-STEP seems to be 97, but in PINS_RUMBA it's 54

This is really confusing. I need to use some of the pins on EXP3 but it's not clear what PINS.H should have to use this pins.

I've checked all the docs. Please advise?

        == John ==

jgwinner, 2019-12-09:
Anyone? I just need to know the correct pins, and what pins on the motherboard correspond to what pins in Marlin.

        == John ==

Aurawin, 2019-12-09:
Tango is a rumba variant. Almost all of the pins are specified in the pins_rumba.h. And perhaps even inherited header file.

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

jgwinner, 2019-12-09:
That's incorrect. I've built a spreadsheet. There are many pins that are not specified, and from the diagram, as I noted above, some are inconsistent.

On the PCB Diagram, Y-STEP is pin 97, but in PINS_RUMBA it's 54.

jgwinner, 2020-01-01:
So, what is Y-Step? Pin 97, or pin 54? What about the rest of them?

== John ==

Aurawin, 2020-01-01:
I have no problems with the existing stepper pin mappings.  I run a Tronxy X5S with Dual Z Steppers.
I am curious to know what if any symptoms exist with respect to the Y stepper driver.

McUtty, 2021-11-06:
Here I find how to config 2 Fan with the TANGO Board:
https://www.digitales-minden.de/wiki/bigtreetech-biqu-board-tango-fan1-enable-configuartion-h

Thread 11 (2020-06-02):

Connecting tmc2208 in uart; what pins for xyze?

Smarty4life, 2020-06-02:
trying to get 256 steps and all that jazz. Can't seem to find pin arrangement from y split to board.

Smarty4life, 2020-06-02:
tango board/biqu110-a3

Smarty4life, 2020-06-02:
Must change rx and tx in configuration adv.h for aux2

Closed 2020-06-02.
